gavin4d/dangerDoughnut/PCB/XT30RightAngleAdapter/production/bom.csv

Designator | Footprint | Quantity | Value | LCSC Part #
J1 | AMASS_XT30UPB-F_1x02_P5.0mm_Vertical | 1 | Conn_01x02_Pin
J2 | 0201 | 1 | Conn_01x02_Pin
