gavin4d/dangerDoughnut/PCB/LEDStick/LEDStick.step

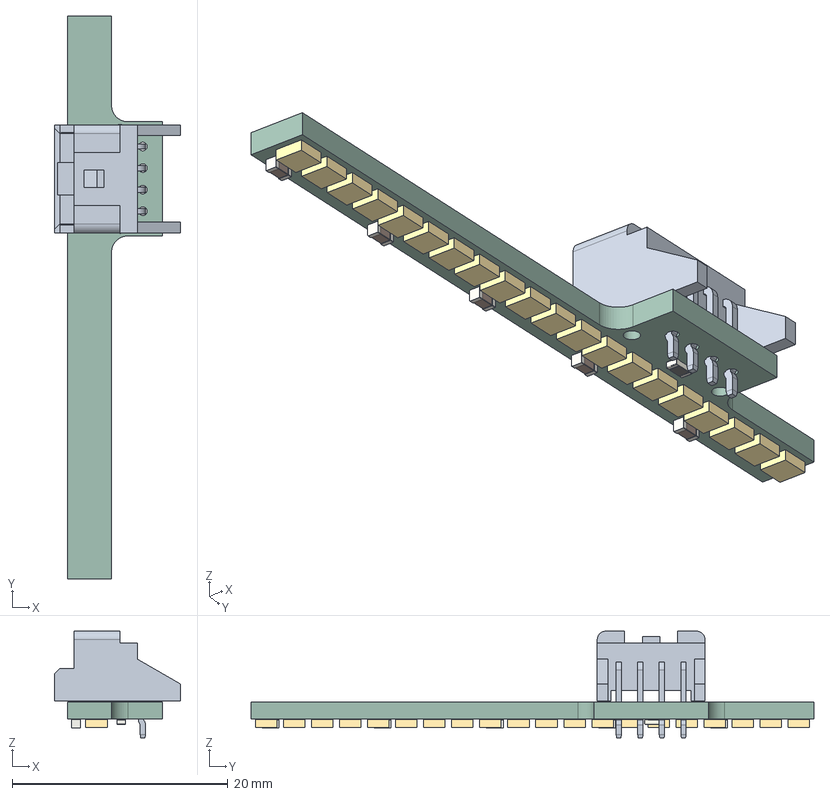
[picture p1: CAD file, 2024-07-29]
PCB/LEDStick/LEDStick.step
11.7 x 52.2 x 9.90 mm
S04B-PASK-2
C_0603_1608Metric x 5
Fuse_0603_1608Metric
_autosave-LEDStick_PCB
