gavin4d/dangerDoughnut/PCB/PowerSwitch/CAD/XT30UPB-F.step

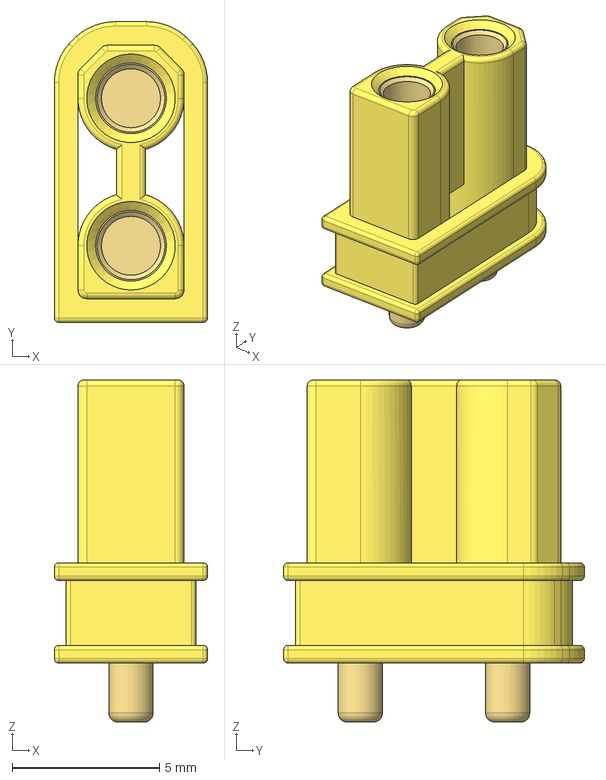
[picture p2: CAD file, 2024-07-29]
PCB/PowerSwitch/CAD/XT30UPB-F.step
5.20 x 10.2 x 11.6 mm
XT30UPB-F x 3
