gavin4d/dangerDoughnut/PCB/PowerSwitch/PowerSwitchV0.2.step

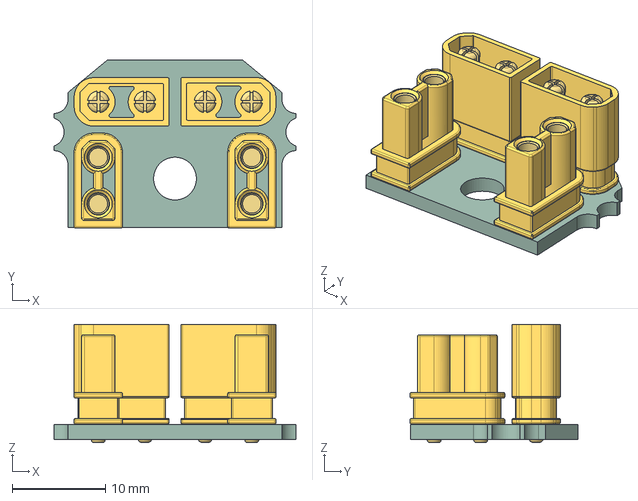
[picture p3: CAD file, 2025-03-31]
PCB/PowerSwitch/PowerSwitchV0.2.step
26.0 x 18.1 x 12.7 mm
Assembly x 4
PowerSwitch_PCB
