gavin4d/dangerDoughnut/PCB/XT30RightAngleAdapter/XT30RightAngleAdapterF.step

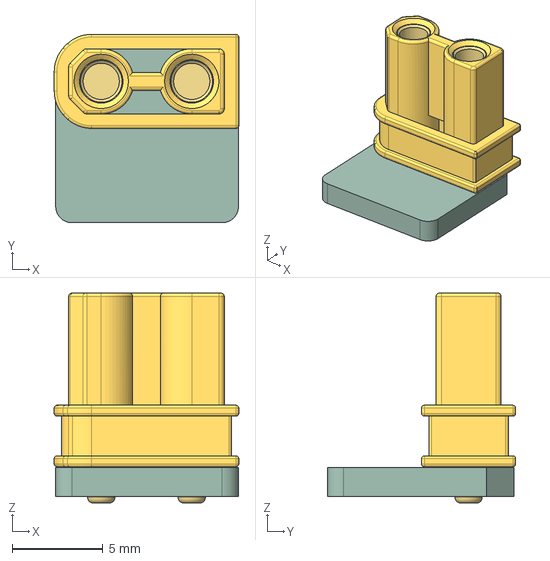
[picture p4: CAD file, 2024-08-08]
PCB/XT30RightAngleAdapter/XT30RightAngleAdapterF.step
10.2 x 10.4 x 11.6 mm
Assembly
_autosave-XT30RightAngleAdapter_PCB
