gavin4d/dangerDoughnut/PCB/DangerDoughnut/CAD/S04B-PASK-2(LF)(SN)--3DModel-STEP-56544.STEP

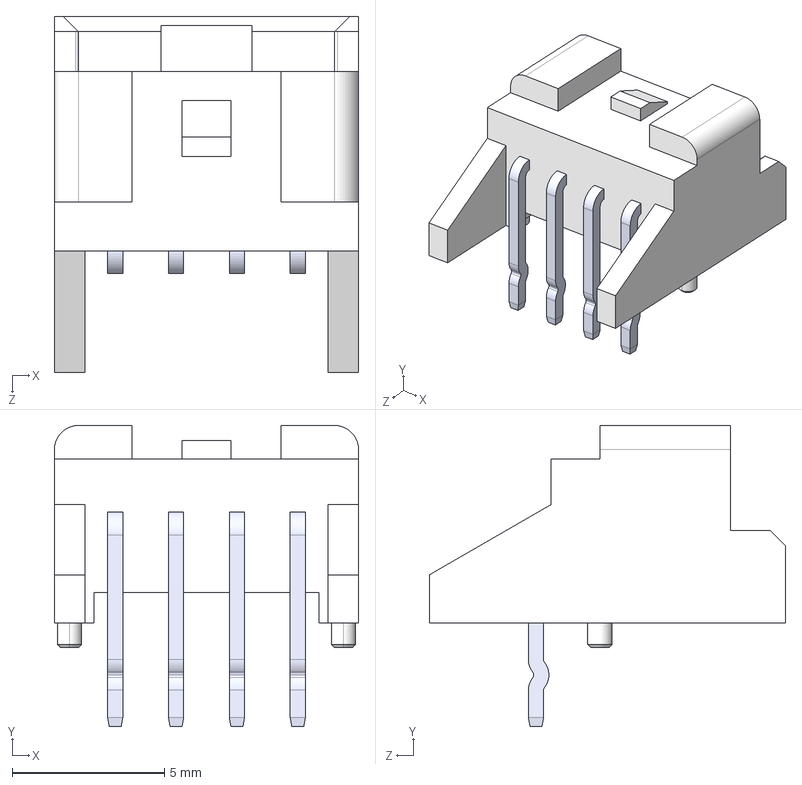
[picture p5: CAD file, 2024-07-29]
PCB/DangerDoughnut/CAD/S04B-PASK-2(LF)(SN)--3DModel-STEP-56544.STEP
10.0 x 9.90 x 11.7 mm
