gavin4d/dangerDoughnut/PCB/PowerSwitch/CAD/XT30UPB-M.step

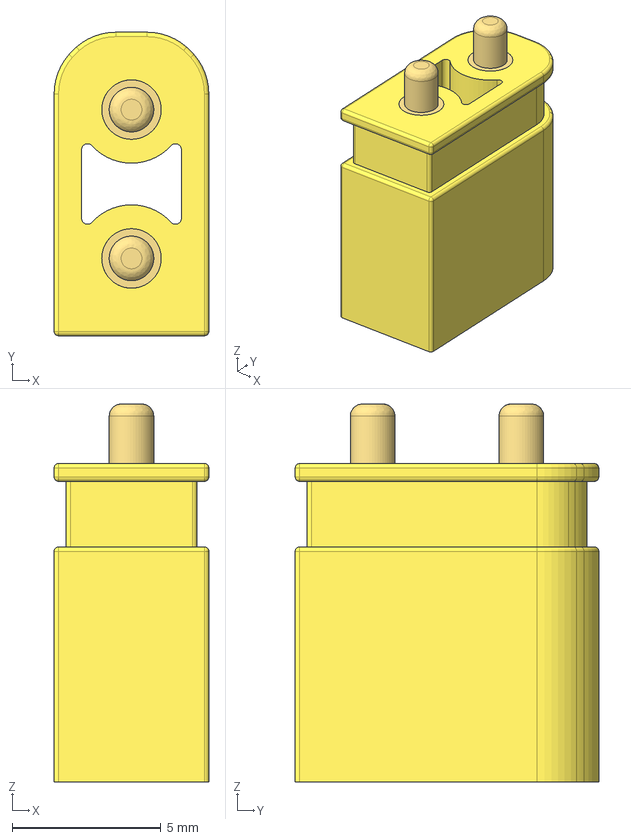
[picture p6: CAD file, 2024-07-29]
PCB/PowerSwitch/CAD/XT30UPB-M.step
5.20 x 10.2 x 12.7 mm
XT30UPB-M x 3
