gavin4d/dangerDoughnut/PCB/XT30RightAngleAdapter/XT30RightAngleAdapter.step

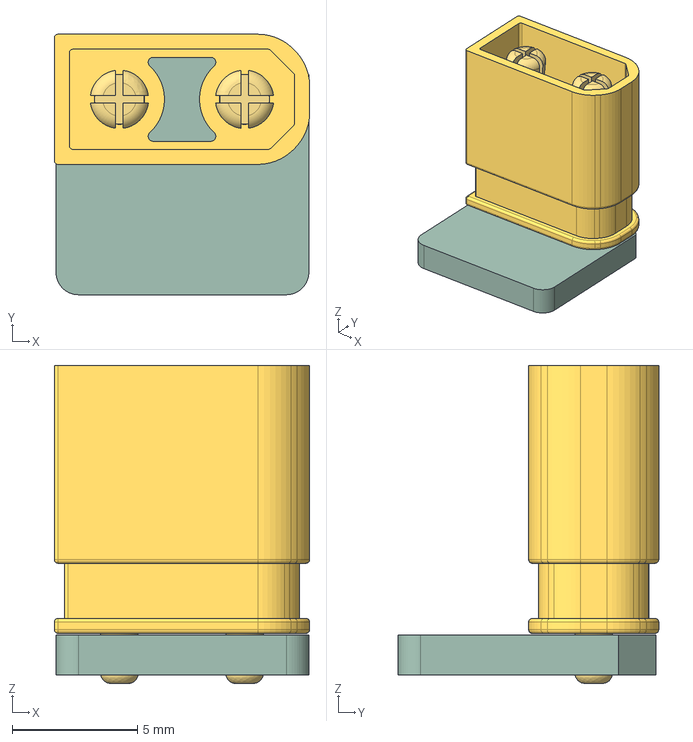
[picture p7: CAD file, 2024-08-08]
PCB/XT30RightAngleAdapter/XT30RightAngleAdapter.step
10.2 x 10.4 x 12.7 mm
Assembly
_autosave-XT30RightAngleAdapter_PCB
