gavin4d/dangerDoughnut/PCB/DangerDoughnut/CAD/QFN32_5X5_EXP.step

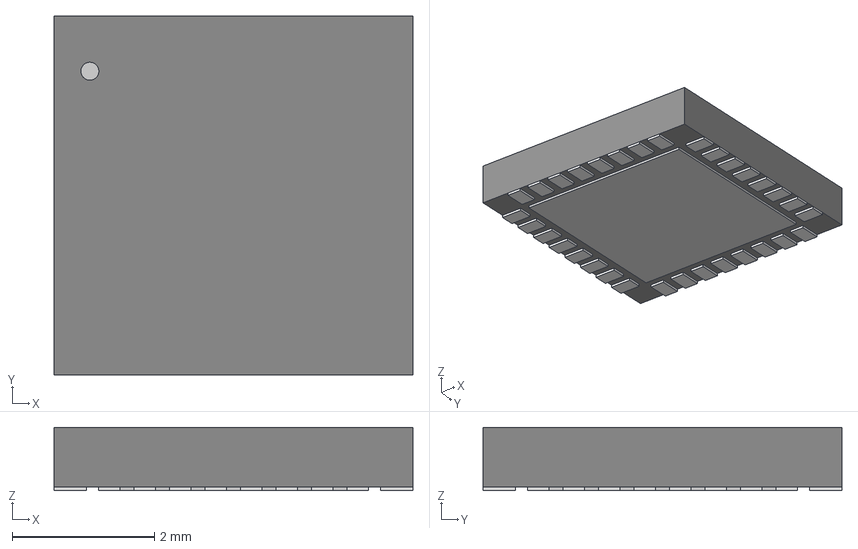
[picture p8: CAD file, 2024-07-29]
PCB/DangerDoughnut/CAD/QFN32_5X5_EXP.step
5.05 x 5.05 x 0.892 mm
