gavin4d/dangerDoughnut/PCB/DangerDoughnut/CAD/QFN24_4X4_SEM.step

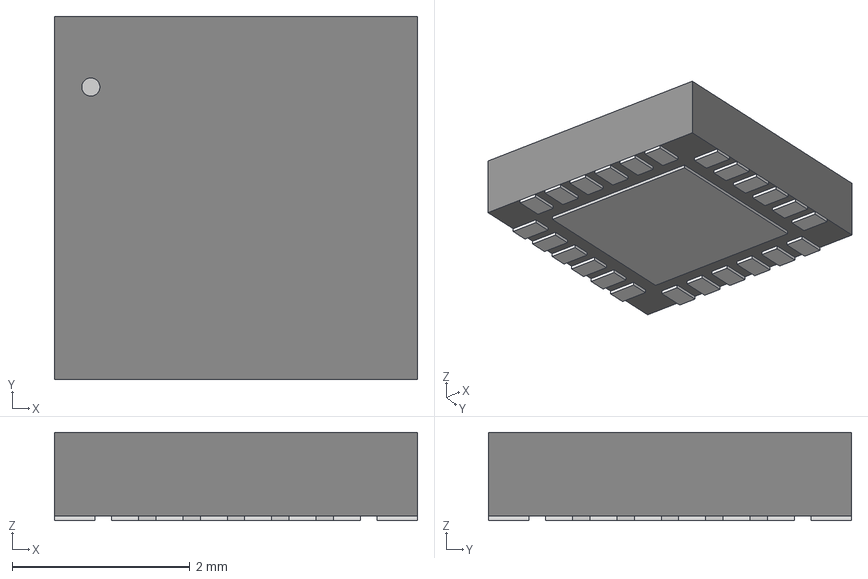
[picture p9: CAD file, 2024-07-29]
PCB/DangerDoughnut/CAD/QFN24_4X4_SEM.step
4.09 x 4.09 x 0.993 mm
