gavin4d/dangerDoughnut/PCB/DangerDoughnut/CAD/HSOP8_STM.step

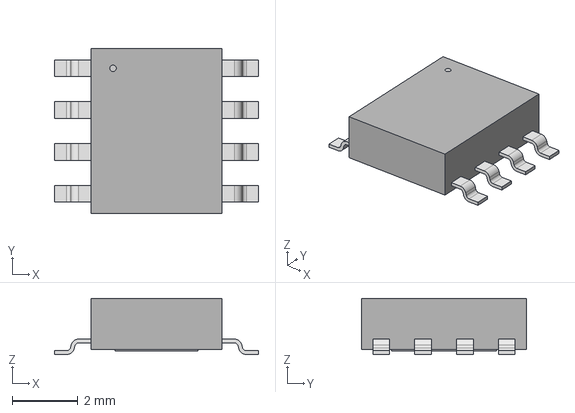
[picture p10: CAD file, 2024-07-29]
PCB/DangerDoughnut/CAD/HSOP8_STM.step
6.20 x 5.00 x 1.70 mm
