gavin4d/dangerDoughnut/PCB/DangerDoughnut/CAD/QFN_31DLTR_STM.step

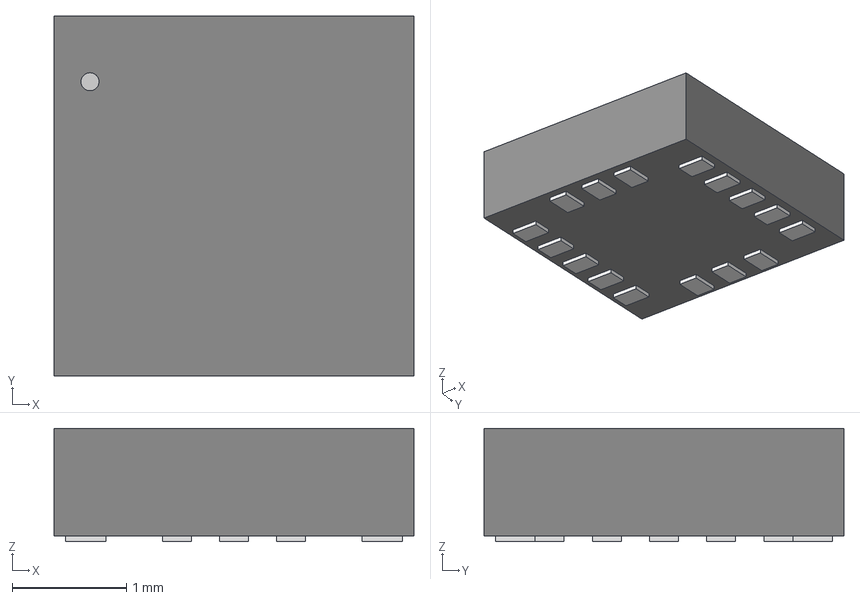
[picture p11: CAD file, 2024-07-29]
PCB/DangerDoughnut/CAD/QFN_31DLTR_STM.step
3.15 x 3.15 x 0.993 mm
