gavin4d/dangerDoughnut/PCB/DangerDoughnut/CAD/MMC5983MA_MEM.step

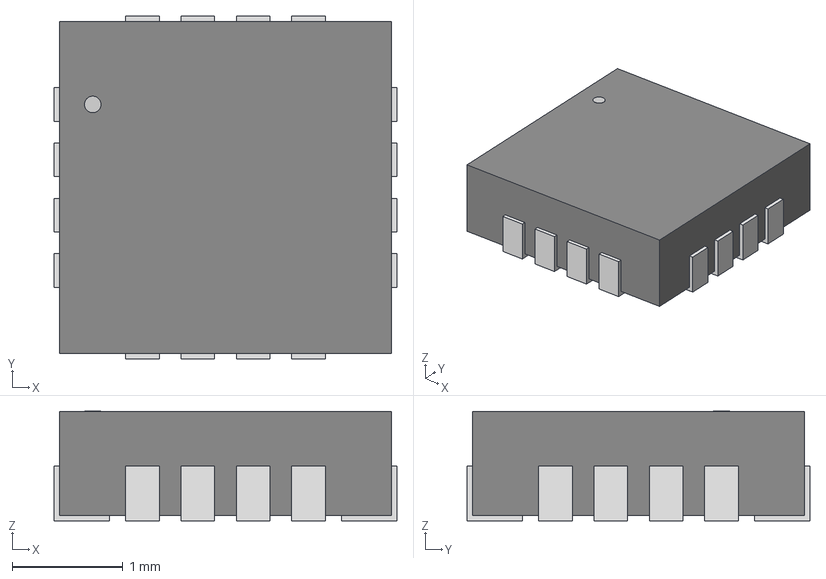
[picture p12: CAD file, 2024-07-29]
PCB/DangerDoughnut/CAD/MMC5983MA_MEM.step
3.10 x 3.10 x 0.993 mm
