gavin4d/dangerDoughnut/PCB/DangerDoughnut/CAD/sru1038.stp

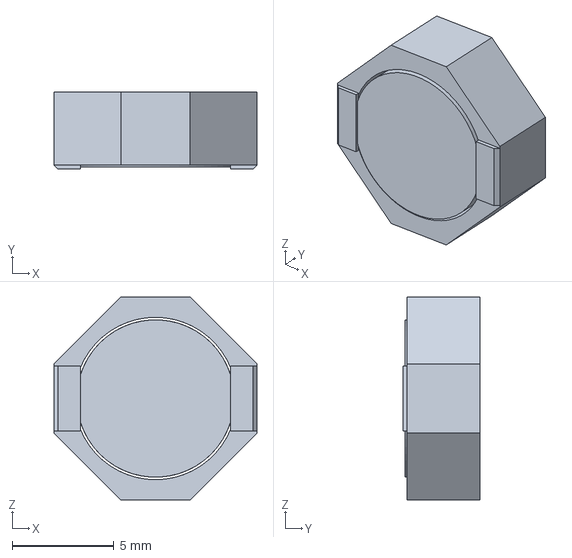
[picture p13: CAD file, 2024-07-29]
PCB/DangerDoughnut/CAD/sru1038.stp
10.0 x 3.80 x 10.0 mm
