gavin4d/dangerDoughnut/PCB/DangerDoughnut/CAD/S02B-PASK-2--3DModel-STEP-272129.STEP

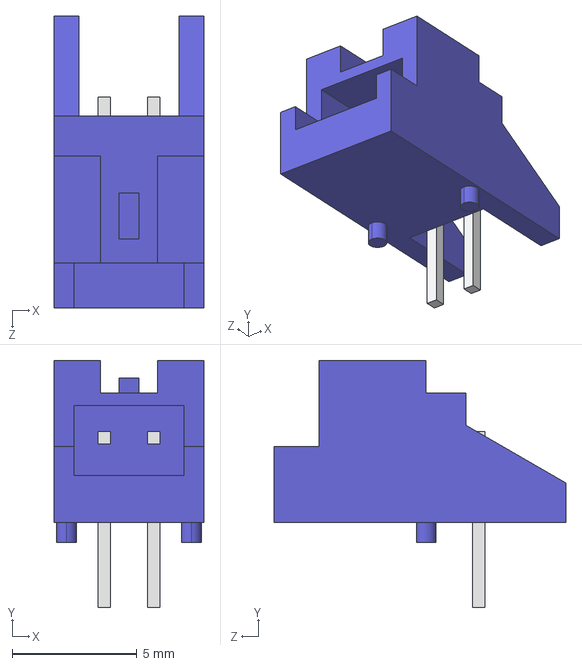
[picture p14: CAD file, 2024-07-29]
PCB/DangerDoughnut/CAD/S02B-PASK-2--3DModel-STEP-272129.STEP
6.00 x 9.90 x 11.7 mm
