gavin4d/dangerDoughnut/PCB/DangerDoughnut/CAD/Amass_XT30PW-M_pcb solder.stp

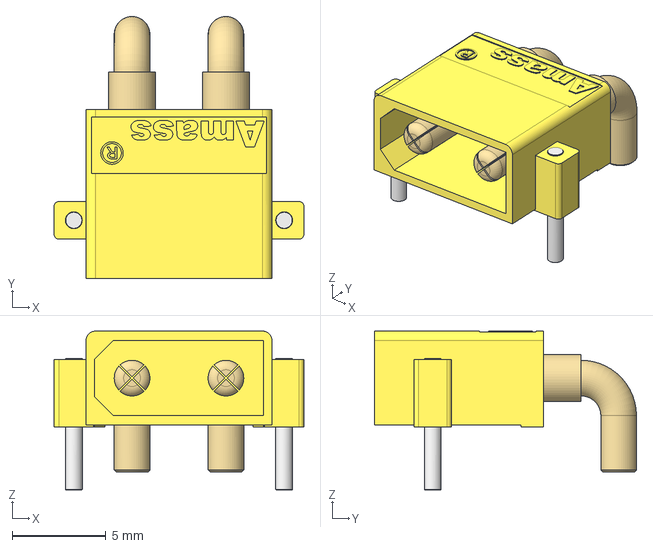
[picture p15: CAD file, 2024-07-29]
PCB/DangerDoughnut/CAD/Amass_XT30PW-M_pcb solder.stp
13.3 x 13.9 x 8.45 mm
