gavin4d/dangerDoughnut/PCB/DangerDoughnut/CAD/SMB_STM.step

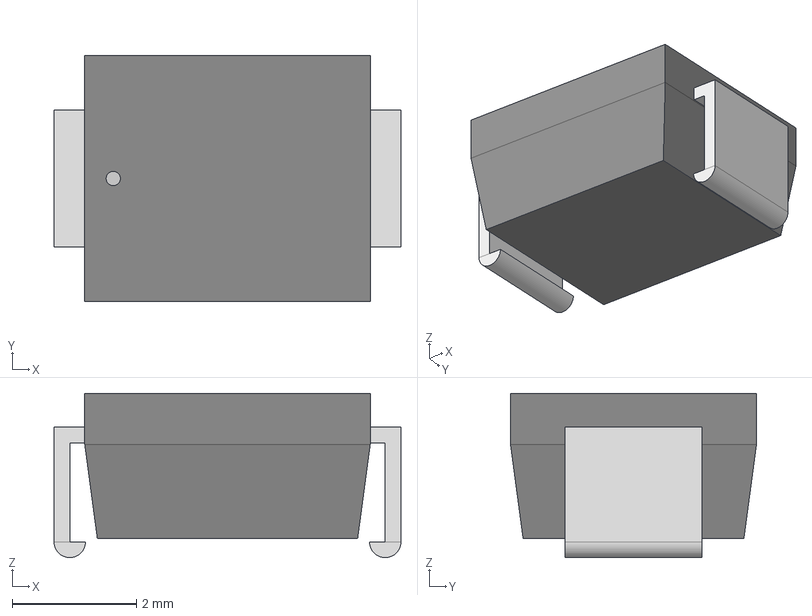
[picture p16: CAD file, 2024-07-29]
PCB/DangerDoughnut/CAD/SMB_STM.step
5.59 x 3.96 x 2.64 mm
