gavin4d/dangerDoughnut/PCB/DangerDoughnut/CAD/DR74.step

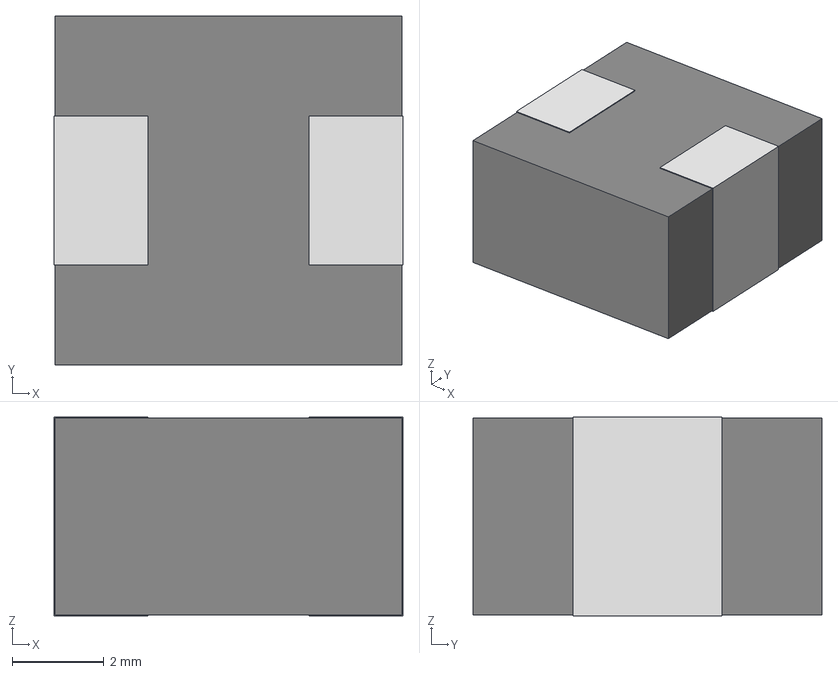
[picture p17: CAD file, 2024-07-29]
PCB/DangerDoughnut/CAD/DR74.step
7.62 x 7.62 x 4.34 mm
