gavin4d/dangerDoughnut/(list of files, cad)

Other CAD files:
PCB/DangerDoughnut/CAD/479480001.stp
PCB/PowerSwitch/PowerSwitch.step
