gavin4d/dangerDoughnut/PCB/XT30RightAngleAdapter/production/ordering_instructions.txt

Ordering Instructions:
Panel dimensions: 73.70 x 75.10 mm.
Solder Mask: Red (Default)
Silkscreen: White (Default)
Layers: 2
Finish: HASL Lead-free (Default)
Thickness: 1.6mm (Default)
Copper weight: 1oz (Default)
Minimum track width: 0.60mm (23.62mil)
Minimum via drill: 0.30mm (11.81mil)
