gavin4d/dangerDoughnut/PCB/DangerDoughnut/DangerDoughnut.kicad_pcb

## KiCad design PCB/DangerDoughnut/DangerDoughnut.kicad_pcb (2025-11-01)

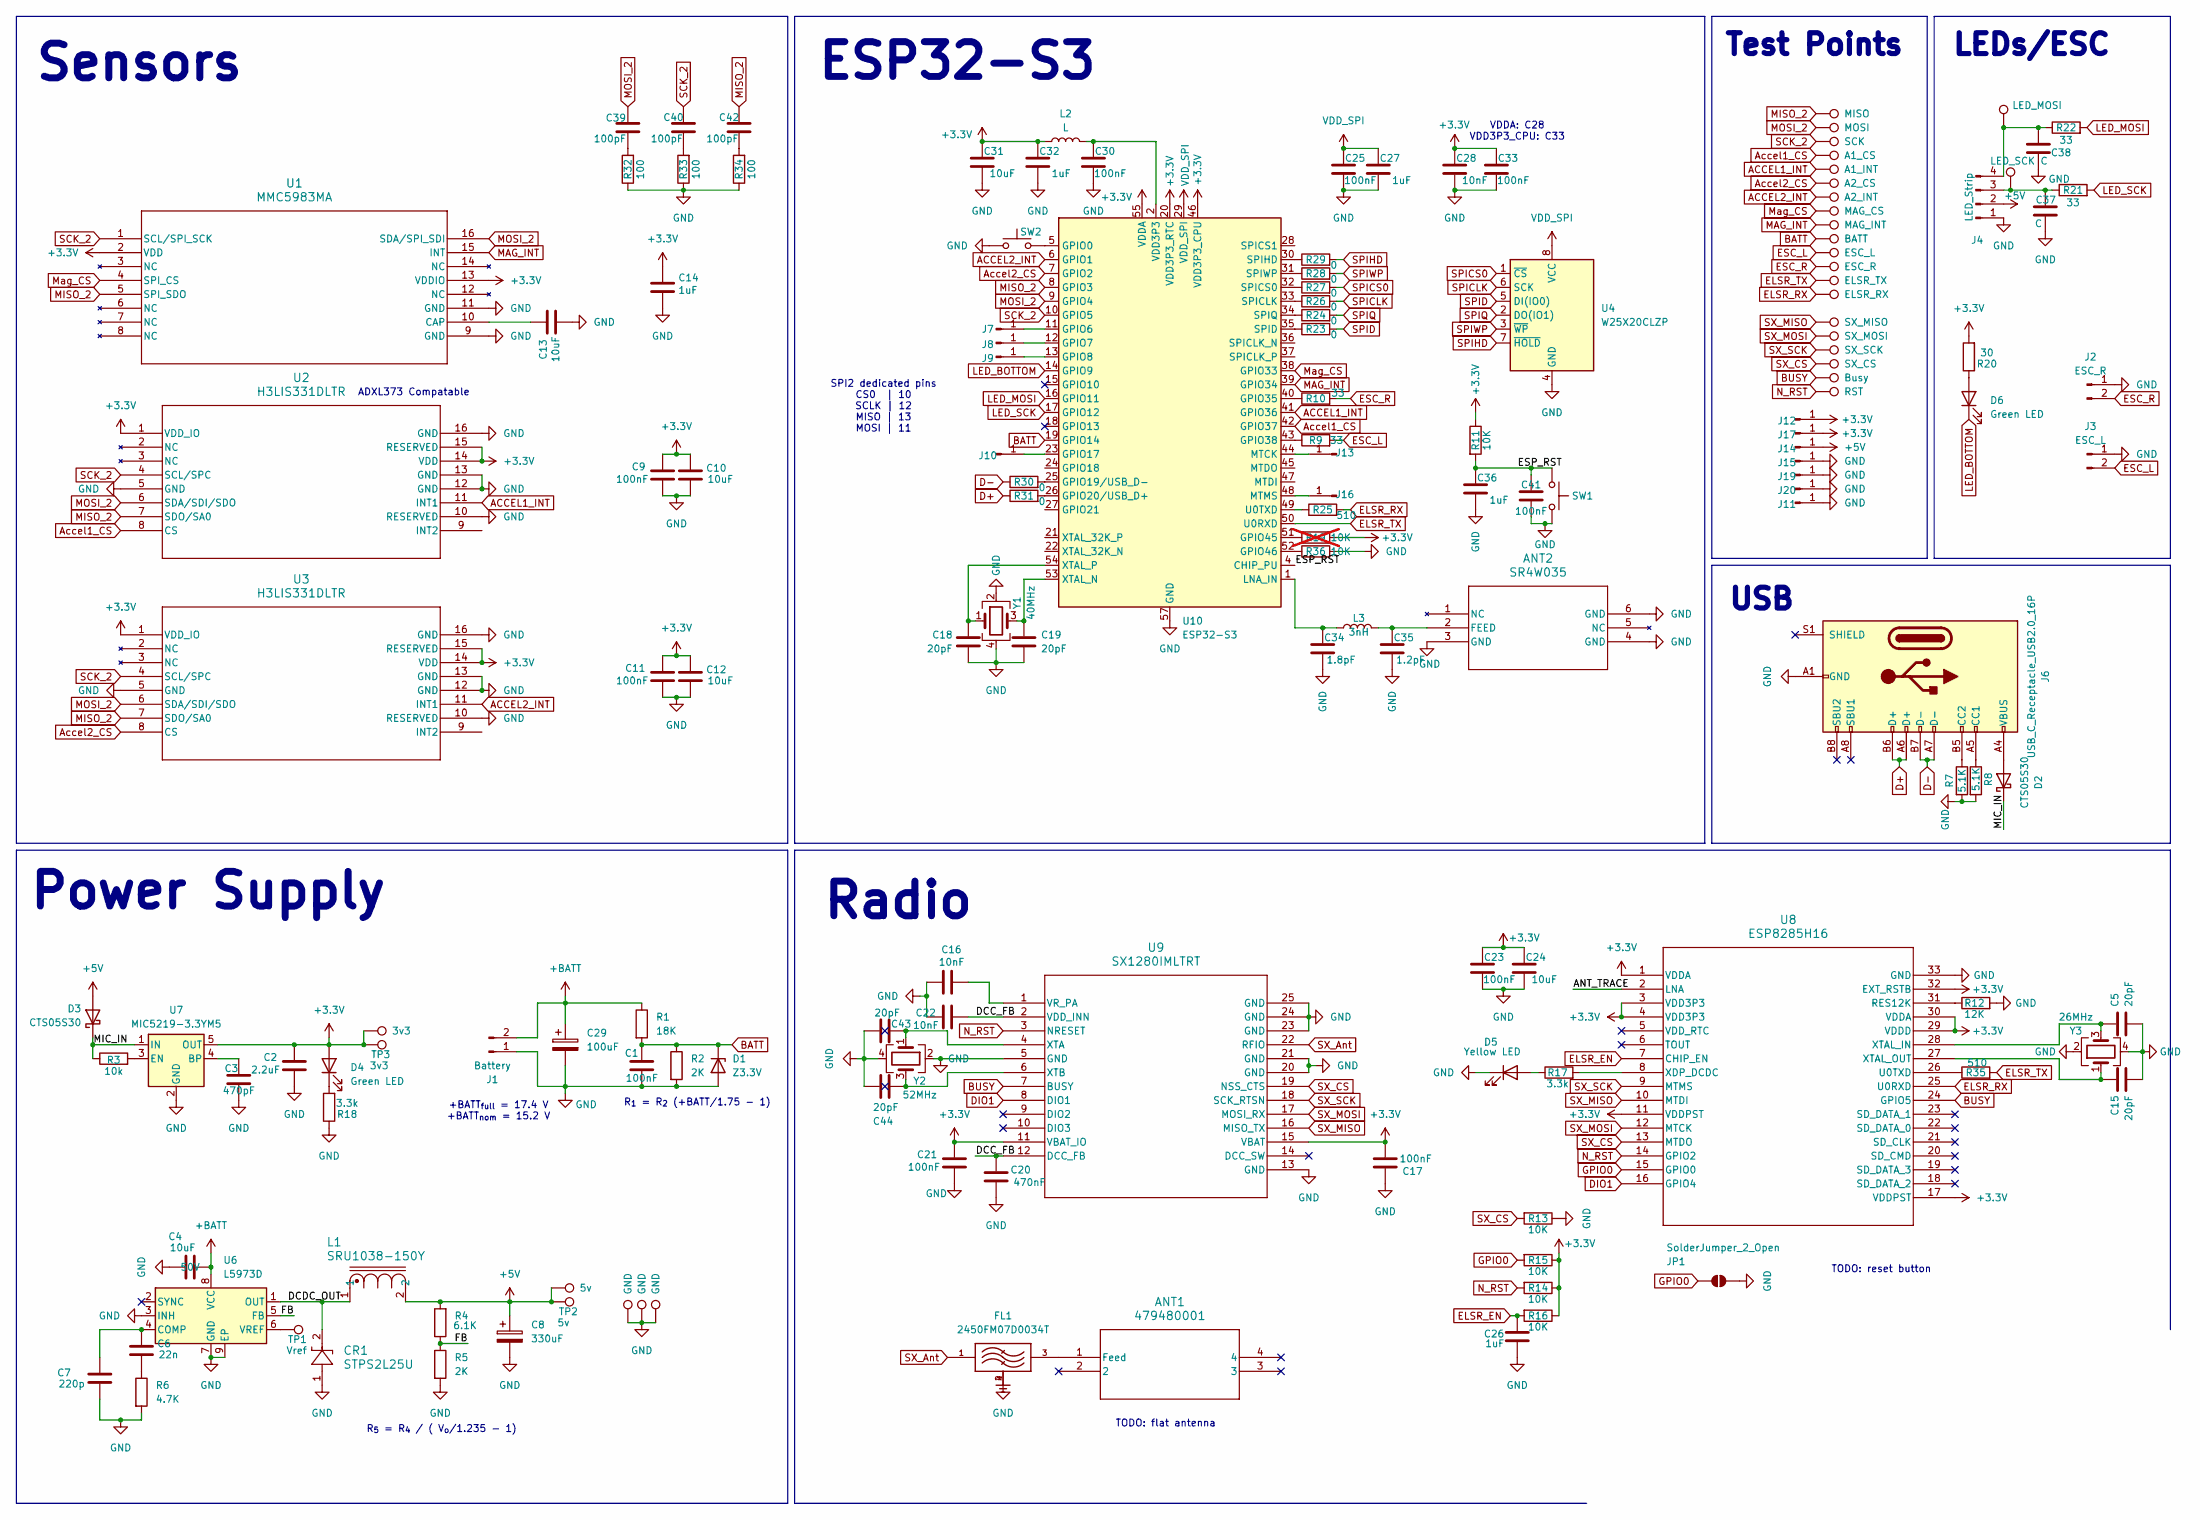
[picture p18: schematic DangerDoughnut.kicad_sch, Danger Doughnut]

Parts:
ANT1: 479480001; ANT_47948-0001_MOL
ANT2: SR4W035; SR4W035_4X6_ANT
C1, C9, C11, C17, C21, C23, C25, C30, C33, C41: 100nF; C_0402_1005Metric
C2: 2.2uF; C_0402_1005Metric
C3: 470pF; C_0402_1005Metric
C4: 10uF; C_1206_3216Metric_Pad1.33x1.80mm_HandSolder; Voltage 50V
C5, C15, C18, C19, C43, C44: 20pF; C_0402_1005Metric_Pad0.74x0.62mm_HandSolder
C6: 22n; C_0402_1005Metric
C7: 220p; C_0402_1005Metric
C8: 330uF; CP_Radial_D6.3mm_P2.50mm
C10, C12, C13, C24, C31: 10uF; C_0805_2012Metric_Pad1.18x1.45mm_HandSolder
C14, C26, C27, C32, C36: 1uF; C_0402_1005Metric
C16, C22, C28: 10nF; C_0402_1005Metric
C20: 470nF; C_0402_1005Metric
C29: 100uF; CP_Right_Angle_D6.3_P2.50_H16.5
C34: 1.8pF; C_0402_1005Metric
C35: 1.2pF; C_0402_1005Metric
C37, C38: C; C_0402_1005Metric
C39, C40, C42: 100pF; C_0402_1005Metric
CR1: STPS2L25U; SMB_STM
D1: Z3.3V; D_SOD-123
D2, D3: CTS05S30; D_0805_2012Metric
D4, D6: Green LED; LED_0805_2012Metric
D5: Yellow LED; LED_0805_2012Metric
FL1: 2450FM07D0034T; FIL_2450FM07D0034T; PARTREV 1.2
J1: Battery; AMASS_XT30PW-M_1x02_P2.50mm_Horizontal
J2: ESC_R; JST_S02B-PASK-2_LF__SN__1
J3: ESC_L; JST_S02B-PASK-2_LF__SN__1
J4: LED_Strip; JST_S04B-PASK-2_LF__SN_
J6: USB_C_Receptacle_USB2.0_16P; USB_C_Receptacle_GCT_USB4105-xx-A_16P_TopMnt_Horizontal
J7, J8, J9, J10, J11, J12, J13, J14, J15, J16, J17, J19, J20: Conn_01x01_Pin; SolderWirePad_1x01_SMD_1x2mm
JP1: SolderJumper_2_Open; SolderJumper-2_P1.3mm_Open_RoundedPad1.0x1.5mm
L1: SRU1038-150Y; DR74
L2: L; L_0402_1005Metric_Pad0.77x0.64mm_HandSolder
L3: 3nH; L_0402_1005Metric_Pad0.77x0.64mm_HandSolder
R1: 18K; R_0402_1005Metric
R2, R5: 2K; R_0402_1005Metric
R3: 10k; R_0402_1005Metric
R4: 6.1K; R_0402_1005Metric
R6: 4.7K; R_0402_1005Metric
R7, R8: 5.1K; R_0402_1005Metric
R9, R10, R21, R22: 33; R_0402_1005Metric
R11, R13, R14, R15, R16, R36: 10K; R_0402_1005Metric
R12: 12K; R_0402_1005Metric
R17, R18: 3.3k; R_0402_1005Metric
R19: 10K; R_0402_1005Metric; not fitted
R20: 30; R_0402_1005Metric
R23, R24, R26, R27, R28, R29, R30, R31: 0; R_0402_1005Metric
R25, R35: 510; R_0402_1005Metric
R32, R33, R34: 100; R_0402_1005Metric
SW1, SW2: SW_Push; Pad_Button
TP1: Vref; TestPoint_Pad_D1.0mm
TP2: 5v; TestPoint_Pad_D1.0mm
TP3: 3v3; TestPoint_Pad_D1.0mm
TP4: SX_MISO; Test_Via_small
TP5: MISO; Test_Via
TP6: MOSI; Test_Via
TP7: SCK; Test_Via
TP8: ELSR_TX; Test_Via
TP9: ELSR_RX; Test_Via
TP10: A1_CS; Test_Via
TP11: A1_INT; Test_Via
TP12: A2_CS; Test_Via
TP13: A2_INT; Test_Via
TP14: MAG_CS; Test_Via
TP15: MAG_INT; Test_Via
TP16: BATT; Test_Via
TP17: SX_MOSI; Test_Via_small
TP18: LED_MOSI; Test_Via
TP19: LED_SCK; Test_Via
TP20: ESC_L; Test_Via
TP21: ESC_R; Test_Via
TP22: SX_SCK; Test_Via_small
TP23: SX_CS; Test_Via_small
TP24: Busy; Test_Via_small
TP25: RST; Test_Via_small
TP26: 5v; Test_Via
TP27: 3v3; Test_Via
TP28, TP29, TP30: GND; Test_Via
U1: MMC5983MA; MMC5983MA_MEM
U2, U3: H3LIS331DLTR; QFN_31DLTR_STM
U4: W25X20CLZP; SOIC-8_5.23x5.23mm_P1.27mm
U6: L5973D; HSOP-8-1EP_3.9x4.9mm_P1.27mm_EP2.41x3.1mm_ThermalVias
U7: MIC5219-3.3YM5; SOT-23-5
U8: ESP8285H16; QFN32_5X5_EXP
U9: SX1280IMLTRT; QFN24_4X4_SEM
U10: ESP32-S3; QFN-56-1EP_7x7mm_P0.4mm_EP4x4mm
Y1: 40MHz; Crystal_SMD_2016-4Pin_2.0x1.6mm
Y2: 52MHz; Crystal_SMD_2016-4Pin_2.0x1.6mm
Y3: 26MHz; Crystal_SMD_2016-4Pin_2.0x1.6mm

Connections:
+3.3V: C2.1, C9.1, C10.2, C11.1, C12.2, C14.2, C17.2, C21.1, C23.1, C24.1, C28.1, C31.1, C32.1, C33.1, D4.2 (A), J12.1, J17.1, L2.1, R11.1, R14.1, R15.1, R16.1, R19.2, R20.2, TP3.1, TP27.1, U1.2 (VDD), U1.13 (VDDIO), U2.1 (VDD_IO), U2.14 (VDD), U2.15 (RESERVED), U3.1 (VDD_IO), U3.14 (VDD), U3.15 (RESERVED), U7.5 (OUT), U8.1 (VDDA), U8.3 (VDD3P3), U8.4 (VDD3P3), U8.11 (VDDPST), U8.17 (VDDPST), U8.29 (VDDD), U8.30 (VDDA), U8.32 (EXT_RSTB), U9.11 (VBAT_IO), U9.15 (VBAT), U10.20 (VDD3P3_RTC), U10.46 (VDD3P3_CPU), U10.55 (VDDA), U10.56 (VDDA)
+5V: C8.1, D3.2 (A), J4.2, J14.1, L1.2, R4.2, TP2.1, TP26.1
+BATT: C4.2, C29.1, J1.2, R1.1, U6.8 (VCC)
/ANT_TRACE: U8.2 (LNA)
/DCC_FB: C20.1, C22.1, U9.2 (VDD_INN), U9.12 (DCC_FB)
/DCDC_OUT: CR1.2, L1.1, U6.1 (OUT)
/ESP_RST: C36.1, C41.1, R11.2, SW1.1, U10.4 (CHIP_PU)
/FB: R4.1, R5.1, U6.5 (FB)
/MIC_IN: D2.1 (K), D3.1 (K), R3.1, U7.1 (IN)
ACCEL1_INT: TP11.1, U2.11 (INT1), U10.41 (GPIO36)
ACCEL2_INT: TP13.1, U3.11 (INT1), U10.6 (GPIO1)
Accel1_CS: TP10.1, U2.8 (CS), U10.42 (GPIO37)
Accel2_CS: TP12.1, U3.8 (CS), U10.7 (GPIO2)
BATT: C1.1, D1.1 (K), R1.2, R2.1, TP16.1, U10.19 (GPIO14)
BUSY: TP24.1, U8.24 (GPIO5), U9.7 (BUSY)
D+: J6.A6 (D+), J6.B6 (D+), R31.1
D-: J6.A7 (D-), J6.B7 (D-), R30.1
DIO1: U8.16 (GPIO4), U9.8 (DIO1)
ELSR_EN: C26.1, R16.2, U8.7 (CHIP_EN)
ELSR_RX: R25.2, TP9.1, U8.25 (U0RXD)
ELSR_TX: R35.2, TP8.1, U10.50 (U0RXD)
ESC_L: J3.2, R9.2, TP20.1
ESC_R: J2.2, R10.2, TP21.1
GND: ANT2.3 (GND), ANT2.4 (GND), ANT2.6 (GND), C1.2, C2.2, C3.2, C4.1, C5.2, C7.1, C8.2, C9.2, C10.1, C11.2, C12.1, C13.2, C14.1, C15.2, C16.2, C17.1, C18.2, C19.2, C20.2, C21.2, C22.2, C23.2, C24.2, C25.2, C26.2, C27.2, C28.2, C29.2, C30.2, C31.2, C32.2, C33.2, C34.2, C35.2, C36.2, C37.2, C38.2, C41.2, C43.1, C44.1, CR1.1, D1.2 (A), D5.1 (K), FL1.2, FL1.4, J1.1, J2.1, J3.1, J4.1, J6.A1 (GND), J6.A12 (GND), J6.B1 (GND), J6.B12 (GND), J11.1, J15.1, J19.1, J20.1, JP1.1 (A), R2.2, R5.2, R6.2, R7.2, R8.2, R12.2, R13.1, R18.1, R32.1, R33.1, R34.1, R36.2, SW1.2, SW2.1, TP28.1, TP29.1, TP30.1, U1.9 (GND), U1.11 (GND), U2.5 (GND), U2.10 (RESERVED), U2.12 (GND), U2.13 (GND), U2.16 (GND), U3.5 (GND), U3.10 (RESERVED), U3.12 (GND), U3.13 (GND), U3.16 (GND), U4.4 (GND), U6.3 (INH), U6.7 (GND), U6.9 (EP), U7.2 (GND), U8.33 (GND), U9.5 (GND), U9.13 (GND), U9.20 (GND), U9.21 (GND), U9.23 (GND), U9.24 (GND), U9.25 (GND), U10.57 (GND), Y1.2, Y1.4, Y2.2, Y2.4, Y3.2, Y3.4
GPIO0: JP1.2 (B), R15.2, U8.15 (GPIO0)
LED_BOTTOM: D6.1 (K), U10.14 (GPIO9)
LED_MOSI: R22.2, U10.16 (GPIO11)
LED_SCK: R21.2, U10.17 (GPIO12)
MAG_INT: TP15.1, U1.15 (INT), U10.39 (GPIO34)
MISO_2: C42.1, TP5.1, U1.5 (SPI_SDO), U2.7 (SDO/SA0), U3.7 (SDO/SA0), U10.8 (GPIO3)
MOSI_2: C39.1, TP6.1, U1.16 (SDA/SPI_SDI), U2.6 (SDA/SDI/SDO), U3.6 (SDA/SDI/SDO), U10.9 (GPIO4)
Mag_CS: TP14.1, U1.4 (SPI_CS), U10.38 (GPIO33)
N_RST: R14.2, TP25.1, U8.14 (GPIO2), U9.3 (NRESET)
unnamed: ANT1.1 (Feed), FL1.3
unnamed: ANT2.2 (FEED), C35.1, L3.2
unnamed: C6.1, R6.1
unnamed: C30.1, L2.2, U10.2 (VDD3P3), U10.3 (VDD3P3)
unnamed: C39.2, R32.2
unnamed: C40.2, R33.2
unnamed: C42.2, R34.2
unnamed: D2.2 (A), J6.A4 (VBUS), J6.A9 (VBUS), J6.B4 (VBUS), J6.B9 (VBUS)
unnamed: D4.1 (K), R18.2
unnamed: D5.2 (A), R17.1
unnamed: D6.2 (A), R20.1
unnamed: C37.1, J4.3, R21.1, TP19.1
unnamed: C38.1, J4.4, R22.1, TP18.1
unnamed: J6.A5 (CC1), R8.1
unnamed: J6.B5 (CC2), R7.1
unnamed: J7.1, U10.11 (GPIO6)
unnamed: J8.1, U10.12 (GPIO7)
unnamed: J9.1, U10.13 (GPIO8)
unnamed: J10.1, U10.23 (GPIO17)
unnamed: J13.1, U10.44 (MTCK)
unnamed: J16.1, U10.48 (MTMS)
unnamed: C13.1, U1.10 (CAP)
unnamed: C6.2, C7.2, U6.4 (COMP)
unnamed: TP1.1, U6.6 (VREF)
unnamed: C3.1, U7.4 (BP)
unnamed: R3.2, U7.3 (EN)
unnamed: R12.1, U8.31 (RES12K)
unnamed: R35.1, U8.26 (U0TXD)
unnamed: R17.2, U8.8 (XDP_DCDC)
unnamed: C5.1, U8.28 (XTAL_IN), Y3.3
unnamed: C15.1, U8.27 (XTAL_OUT), Y3.1
unnamed: C16.1, U9.1 (VR_PA)
unnamed: C43.2, U9.4 (XTA), Y2.1
unnamed: C44.2, U9.6 (XTB), Y2.3
unnamed: SW2.2, U10.5 (GPIO0)
unnamed: R30.2, U10.25 (GPIO19/USB_D-)
unnamed: R31.2, U10.26 (GPIO20/USB_D+)
unnamed: R10.1, U10.40 (GPIO35)
unnamed: R9.1, U10.43 (GPIO38)
unnamed: R19.1, U10.51 (GPIO45)
unnamed: R36.1, U10.52 (GPIO46)
unnamed: C34.1, L3.1, U10.1 (LNA_IN)
unnamed: R26.1, U10.33 (SPICLK)
unnamed: R27.1, U10.32 (SPICS0)
unnamed: R23.1, U10.35 (SPID)
unnamed: R29.1, U10.30 (SPIHD)
unnamed: R24.1, U10.34 (SPIQ)
unnamed: R28.1, U10.31 (SPIWP)
unnamed: R25.1, U10.49 (U0TXD)
unnamed: C19.1, U10.53 (XTAL_N), Y1.3
unnamed: C18.1, U10.54 (XTAL_P), Y1.1
SCK_2: C40.1, TP7.1, U1.1 (SCL/SPI_SCK), U2.4 (SCL/SPC), U3.4 (SCL/SPC), U10.10 (GPIO5)
SPICLK: R26.2, U4.6 (SCK)
SPICS0: R27.2, U4.1 (~CS)
SPID: R23.2, U4.5 (DI(IO0))
SPIHD: R29.2, U4.7 (~HOLD)
SPIQ: R24.2, U4.2 (DO(IO1))
SPIWP: R28.2, U4.3 (~WP)
SX_Ant: FL1.1, U9.22 (RFIO)
SX_CS: R13.2, TP23.1, U8.13 (MTDO), U9.19 (NSS_CTS)
SX_MISO: TP4.1, U8.10 (MTDI), U9.16 (MISO_TX)
SX_MOSI: TP17.1, U8.12 (MTCK), U9.17 (MOSI_RX)
SX_SCK: TP22.1, U8.9 (MTMS), U9.18 (SCK_RTSN)
VDD_SPI: C25.1, C27.1, U4.8 (VCC), U10.29 (VDD_SPI)

Notes on the sheet:
Sensors
TODO: reset button
USB
ESP32-S3
Radio
Test Points
ADXL373 Compatable
+BATT_{full} = 17.4 V +BATT_{nom} = 15.2 V
LEDs/ESC
Power Supply
TODO: flat antenna
SPI2 dedicated pins CS0 | 10 SCLK | 12 MISO | 13 MOSI | 11
R_{5} = R_{4} / ( V_{o}/1.235 - 1)
VDDA: C28 VDD3P3_CPU: C33
R_{1} = R_{2} (+BATT/1.75 - 1)

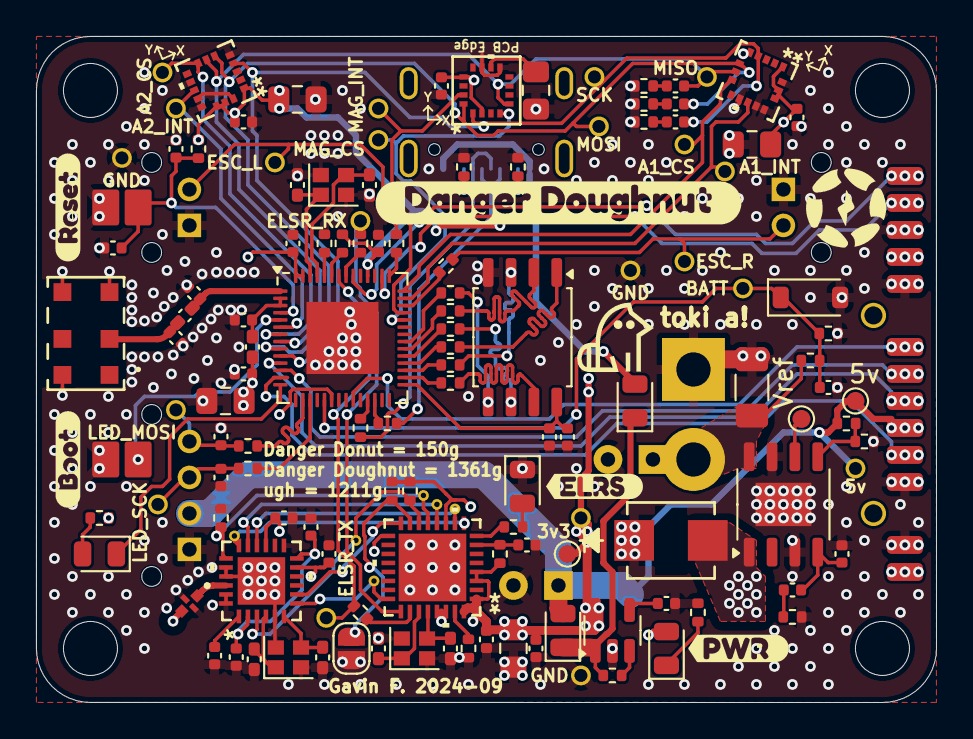
[picture p19: board DangerDoughnut.kicad_pcb from above]

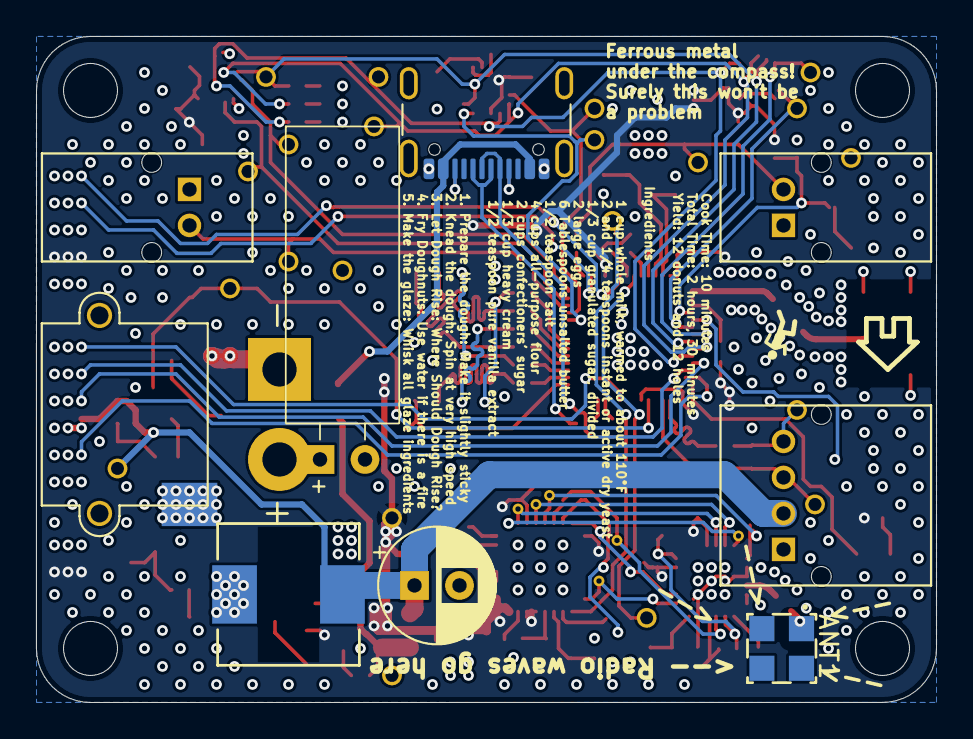
[picture p20: board DangerDoughnut.kicad_pcb from below]

Board: 4 copper layers, 50.0 x 37.0 mm, 161 parts (9 on the bottom side), 96 nets.

Other parts of the board:
kibuzzard-66EFAD11: G***; kibuzzard-66EFAD11
kibuzzard-66EFAD22: G***; kibuzzard-66EFAD22
kibuzzard-66F236AA: G***; kibuzzard-66F236AA
kibuzzard-672AA985: G***; kibuzzard-672AA985
kibuzzard-66936F84: G***; kibuzzard-66936F84
