gavin4d/dangerDoughnut/PCB/LEDStick/LEDStick.kicad_pcb

## KiCad design PCB/LEDStick/LEDStick.kicad_pcb (2024-10-24)

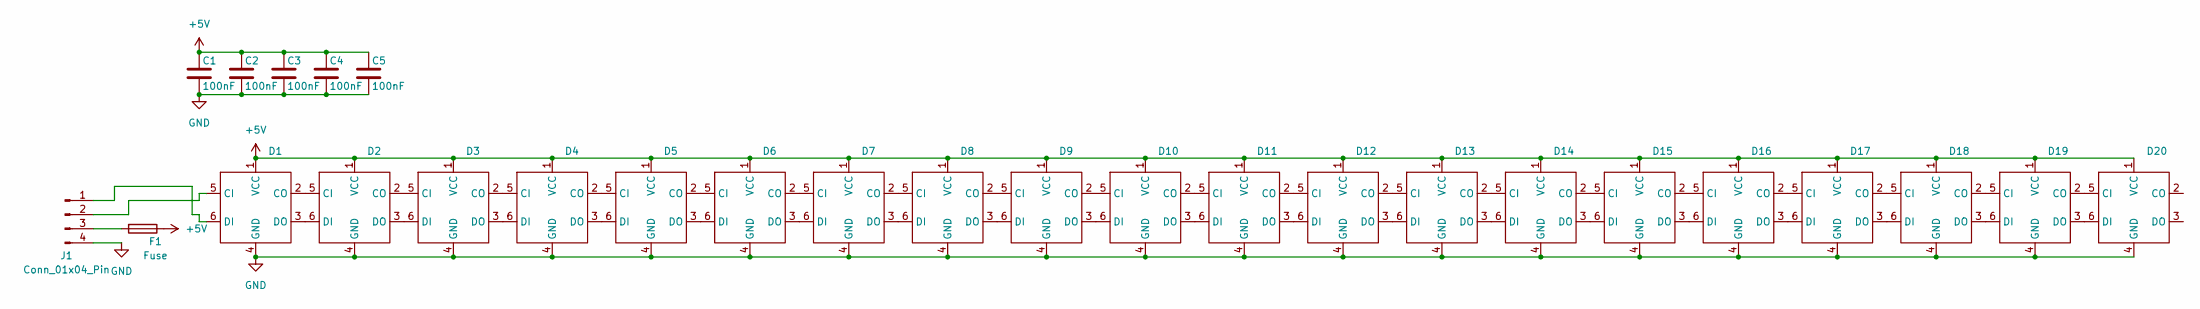
[picture p21: schematic LEDStick.kicad_sch]

Parts:
C1, C2, C3, C4, C5: 100nF; C_0603_1608Metric
D1, D2, D3, D4, D5, D6, D7, D8, D9, D10, D11, D12, D13, D14, D15, D16, D17, D18, D19, D20: HD107s
F1: Fuse; Fuse_0603_1608Metric
J1: Conn_01x04_Pin; JST_S04B-PASK-2_LF__SN_

Connections:
+5V: C1.1, C2.1, C3.1, C4.1, C5.1, D1.1 (VCC), D2.1 (VCC), D3.1 (VCC), D4.1 (VCC), D5.1 (VCC), D6.1 (VCC), D7.1 (VCC), D8.1 (VCC), D9.1 (VCC), D10.1 (VCC), D11.1 (VCC), D12.1 (VCC), D13.1 (VCC), D14.1 (VCC), D15.1 (VCC), D16.1 (VCC), D17.1 (VCC), D18.1 (VCC), D19.1 (VCC), D20.1 (VCC), F1.1
GND: C1.2, C2.2, C3.2, C4.2, C5.2, D1.4 (GND), D2.4 (GND), D3.4 (GND), D4.4 (GND), D5.4 (GND), D6.4 (GND), D7.4 (GND), D8.4 (GND), D9.4 (GND), D10.4 (GND), D11.4 (GND), D12.4 (GND), D13.4 (GND), D14.4 (GND), D15.4 (GND), D16.4 (GND), D17.4 (GND), D18.4 (GND), D19.4 (GND), D20.4 (GND), J1.4
unnamed: D1.5 (CI), J1.2
unnamed: D1.2 (CO), D2.5 (CI)
unnamed: D1.6 (DI), J1.1
unnamed: D1.3 (DO), D2.6 (DI)
unnamed: D2.2 (CO), D3.5 (CI)
unnamed: D2.3 (DO), D3.6 (DI)
unnamed: D3.2 (CO), D4.5 (CI)
unnamed: D3.3 (DO), D4.6 (DI)
unnamed: D4.2 (CO), D5.5 (CI)
unnamed: D4.3 (DO), D5.6 (DI)
unnamed: D5.2 (CO), D6.5 (CI)
unnamed: D5.3 (DO), D6.6 (DI)
unnamed: D6.2 (CO), D7.5 (CI)
unnamed: D6.3 (DO), D7.6 (DI)
unnamed: D7.2 (CO), D8.5 (CI)
unnamed: D7.3 (DO), D8.6 (DI)
unnamed: D8.2 (CO), D9.5 (CI)
unnamed: D8.3 (DO), D9.6 (DI)
unnamed: D9.2 (CO), D10.5 (CI)
unnamed: D10.2 (CO), D11.5 (CI)
unnamed: D9.3 (DO), D10.6 (DI)
unnamed: D10.3 (DO), D11.6 (DI)
unnamed: D11.2 (CO), D12.5 (CI)
unnamed: D11.3 (DO), D12.6 (DI)
unnamed: D12.2 (CO), D13.5 (CI)
unnamed: D12.3 (DO), D13.6 (DI)
unnamed: D13.2 (CO), D14.5 (CI)
unnamed: D13.3 (DO), D14.6 (DI)
unnamed: D14.2 (CO), D15.5 (CI)
unnamed: D14.3 (DO), D15.6 (DI)
unnamed: D15.2 (CO), D16.5 (CI)
unnamed: D15.3 (DO), D16.6 (DI)
unnamed: D16.2 (CO), D17.5 (CI)
unnamed: D16.3 (DO), D17.6 (DI)
unnamed: D17.2 (CO), D18.5 (CI)
unnamed: D17.3 (DO), D18.6 (DI)
unnamed: D18.2 (CO), D19.5 (CI)
unnamed: D18.3 (DO), D19.6 (DI)
unnamed: D19.2 (CO), D20.5 (CI)
unnamed: D19.3 (DO), D20.6 (DI)
unnamed: F1.2, J1.3

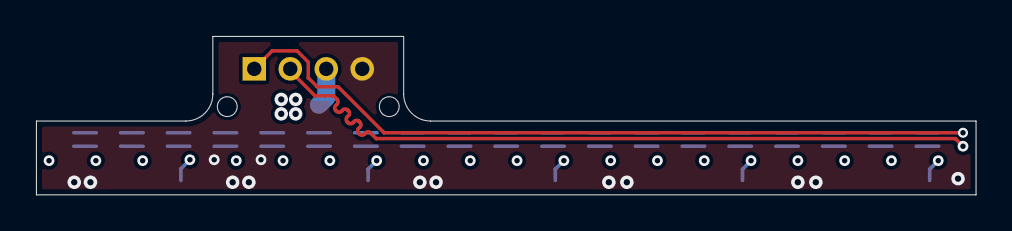
[picture p22: board LEDStick.kicad_pcb from above]

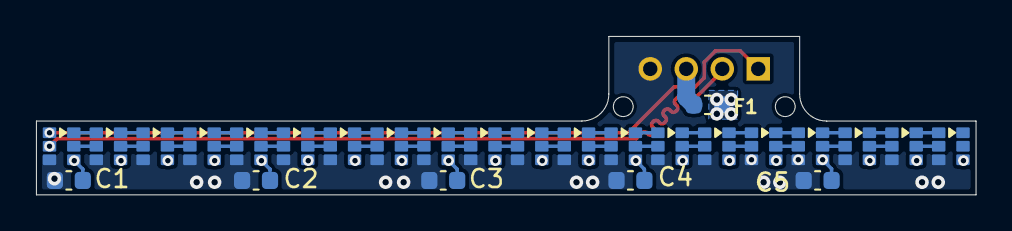
[picture p23: board LEDStick.kicad_pcb from below]

Board: 4 copper layers, 52.2 x 8.8 mm, 27 parts (26 on the bottom side), 43 nets.
