gavin4d/dangerDoughnut/PCB/PowerSwitch/PowerSwitch.kicad_pcb

## KiCad design PCB/PowerSwitch/PowerSwitch.kicad_pcb (2024-08-08)

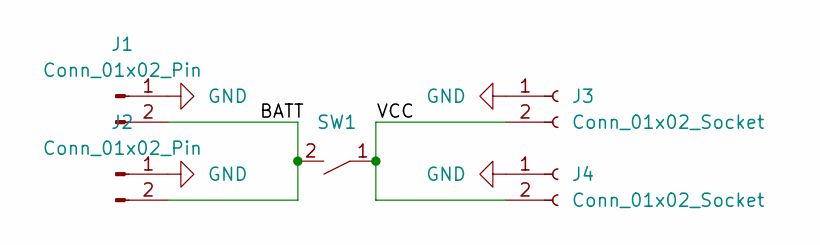
[picture p24: schematic PowerSwitch.kicad_sch]

Parts:
J1, J2: Conn_01x02_Pin; AMASS_XT30UPB-F_1x02_P5.0mm_Vertical
J3, J4: Conn_01x02_Socket; AMASS_XT30UPB-F_1x02_P5.0mm_Vertical
SW1: SMTSO2515_Switch

Connections:
/BATT: J1.2, J2.2, SW1.2
/VCC: J3.2, J4.2, SW1.1
GND: J1.1, J2.1, J3.1, J4.1

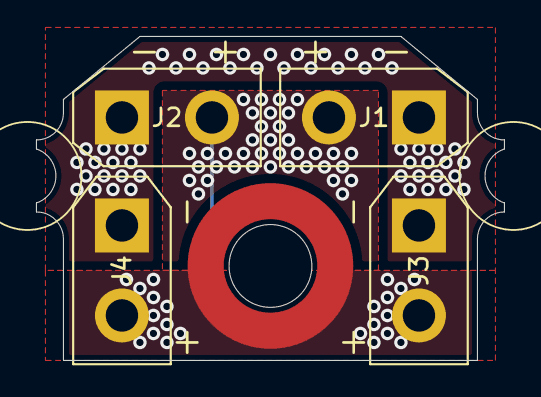
[picture p25: board PowerSwitch.kicad_pcb from above]

Board: 4 copper layers, 26.0 x 18.0 mm, 5 parts (0 on the bottom side), 3 nets.
