gavin4d/dangerDoughnut/firmware/components/MMC5983MA/MMC5983MA.cpp

#include "MMC5983MA.h"
#include "MathUtils.h"
#include "driver/spi_master.h"
#include "esp_intr_alloc.h"
#include "esp_log.h"
#include <bits/std_thread.h>
#include <cstddef>
#include <cstdint>
#include <cstdio>
#include <cstring>
#include "esp_timer.h"
#include "freertos/task.h"

#include "driver/gpio.h"
#include "hal/gpio_types.h"
#include "soc/gpio_num.h"

MMC5983MA::MMC5983MA() {
}

MMC5983MA::~MMC5983MA() {
    free(rx_buffer);
    free(tx_buffer);
}

/*************************************************************************/
/*!
    @brief  Writes 8-bits to the specified destination register

    @param reg The register to write to
    @param value The value to write to the register
*/
/**************************************************************************/

void MMC5983MA::writeRegister(uint8_t reg, uint8_t value) {
    spi_transaction_t transaction = {0};
    transaction.flags = SPI_TRANS_USE_TXDATA;
    transaction.addr = reg | MMC_WRITE;
    transaction.tx_data[0] = value;
    transaction.length = 8;
    // ESP_LOGI("addr_w", "%02x", (uint8_t)transaction.tx_data[0]);

    ret=spi_device_transmit(device, &transaction);
    assert(ret==ESP_OK);
}

/**************************************************************************/
/*!
    @brief  Reads 8-bits from the specified register

    @param reg register to read

    @return The results of the register read request
*/
/**************************************************************************/
uint8_t MMC5983MA::readRegister(uint8_t reg) {
    spi_transaction_t transaction = {0};
    transaction.flags = SPI_TRANS_USE_RXDATA;
    transaction.addr = reg | MMC_READ;
    transaction.length = 8;
    transaction.rxlength = 8;
    // ESP_LOGI("addr_r", "%2x", (uint8_t)transaction.tx_data[0]);

    ret=spi_device_transmit(device, &transaction);
    assert(ret==ESP_OK);
    // ESP_LOGI("read", "%2x", transaction.rx_data[1]);

    return transaction.rx_data[0];
}

/**************************************************************************/
/*!
    @brief  Read the device ID (can be used to check connection)

    @return The 8-bit device ID
*/
/**************************************************************************/
uint8_t MMC5983MA::getDeviceID(void) {
  // Check device ID register
  return readRegister(MMC_PRODUCT_ID_1);
}

/**************************************************************************/
/*!
    @brief  Gets the most recent X axis value

    @return The 16-bit signed value for the X axis
*/
/**************************************************************************/
int16_t MMC5983MA::readX(void) { return 0; }

/**************************************************************************/
/*!
    @brief  Gets the most recent Y axis value

    @return The 16-bit signed value for the Y axis
*/
/**************************************************************************/
int16_t MMC5983MA::readY(void) { return 0; }

/**************************************************************************/
/*!
    @brief  Gets the most recent Z axis value

    @return The 16-bit signed value for the Z axis
*/
/**************************************************************************/
int16_t MMC5983MA::readZ(void) { return 0; }

/**************************************************************************/
/*!
    @brief  Reads 3x16-bits from the x, y, and z data register
    @param vec reference to return vector of magnetic field data
    @return True if the operation was successful, otherwise false.
*/
/**************************************************************************/
bool MMC5983MA::readXYZ(vec3<int16_t> &vec) {
    // ESP_LOGI("mag", "status: %02x", readRegister(MMC_STATUS));
    spi_transaction_t transaction;
    transaction.flags = 0;
    transaction.addr = MMC_X_OUT_0 | MMC_READ;
    transaction.length = 8*6;
    transaction.rxlength = 0; // same as length
    transaction.tx_buffer = NULL;
    transaction.rx_buffer = rx_buffer;

    ret=spi_device_acquire_bus(device, portMAX_DELAY);
    assert(ret==ESP_OK);
    ret=spi_device_polling_transmit(device, &transaction);
    assert(ret==ESP_OK);
    spi_device_release_bus(device);

    // vec.x = (rx_buffer[1] << 10 | rx_buffer[2] << 2 | ((rx_buffer[7] >> 6) & 0b11)) - (1 << 17) + offset.x;
    // vec.y = (rx_buffer[3] << 10 | rx_buffer[4] << 2 | ((rx_buffer[7] >> 4) & 0b11)) - (1 << 17) + offset.y;
    // vec.z = (rx_buffer[5] << 10 | rx_buffer[6] << 2 | ((rx_buffer[7] >> 2) & 0b11)) - (1 << 17) + offset.z;
    vec.x = (rx_buffer[0] << 8 | rx_buffer[1]) - (1<<15) - offset.x;
    vec.y = (rx_buffer[2] << 8 | rx_buffer[3]) - (1<<15) - offset.y;
    vec.z = (rx_buffer[4] << 8 | rx_buffer[5]) - (1<<15) - offset.z;

    // if(receive_flag || gpio_get_level(GPIO_NUM_34)) {
    //     // ESP_LOGI("mag", "status: %02x", readRegister(MMC_STATUS));
    //     printf(" %llu %u\n", (MMC5983MA::receive_time), (uint8_t)gpio_get_level(GPIO_NUM_34));
    //     writeRegister(MMC_STATUS, 0b1);
    //     // writeRegister(MMC_INTERNAL_CONTROL_0, MMC_TAKE_MEASURMENT_M | MMC_INT_EN);
    //     // MMC5983MA::send_time = esp_timer_get_time();
    //     receive_flag = 0;
    //     // vTaskDelay(8);
    //     // ESP_LOGI("mag", "status: %02x", readRegister(MMC_STATUS));
    // }
    return true;
}

/**************************************************************************/
/*!
    @brief  Reads 3x16-bits from the x, y, and z data register
    @param x reference to return x magnetic field data
    @param y reference to return y magnetic field data
    @param z reference to return z magnetic field data
    @return True if the operation was successful, otherwise false.
*/
/**************************************************************************/
bool MMC5983MA::readXY(vec2<int16_t> &vec) {
    spi_transaction_t transaction;
    transaction.flags = 0;
    transaction.addr = MMC_X_OUT_0 | MMC_READ;
    transaction.length = 8*4;
    transaction.rxlength = 0; // same as length
    transaction.tx_buffer = NULL;
    transaction.rx_buffer = rx_buffer;

    ret=spi_device_acquire_bus(device, portMAX_DELAY);
    assert(ret==ESP_OK);
    ret=spi_device_polling_transmit(device, &transaction);
    assert(ret==ESP_OK);
    spi_device_release_bus(device);

    // vec.x = (rx_buffer[1] << 10 | rx_buffer[2] << 2 | ((rx_buffer[7] >> 6) & 0b11)) - (1 << 17) + offset.x;
    // vec.y = (rx_buffer[3] << 10 | rx_buffer[4] << 2 | ((rx_buffer[7] >> 4) & 0b11)) - (1 << 17) + offset.y;
    vec.x = (rx_buffer[0] << 8 | rx_buffer[1]) - (1<<15) - offset.x;
    vec.y = (rx_buffer[2] << 8 | rx_buffer[3]) - (1<<15) - offset.y;
    return true;
}

// uint64_t MMC5983MA::receive_time = 0;
// uint8_t MMC5983MA::receive_flag = 0;
// uint64_t MMC5983MA::send_time = 0;
// static void IRAM_ATTR gpio_interrupt_handler(void *args)
// {
//     MMC5983MA::receive_time = esp_timer_get_time() - MMC5983MA::send_time;
//     MMC5983MA::send_time = esp_timer_get_time();
//     MMC5983MA::receive_flag = 1;
// }

/**************************************************************************/
/*!
    @brief  Setups the HW (reads coefficients values, etc.)
    @return True if the sensor was successfully initialised.
*/
/**************************************************************************/
bool MMC5983MA::setup(sensor_config_t config) {

    rx_buffer = (uint8_t*)heap_caps_aligned_alloc(32, 8, MALLOC_CAP_DMA);
    tx_buffer = (uint8_t*)heap_caps_aligned_alloc(32, 8, MALLOC_CAP_DMA);

    DMA_channel = config.DMA_channel;
    SPI_host = config.SPI_host;
    clock_speed = config.clock_speed;
    bus_config = {
        .mosi_io_num = config.mosi_pin,
        .miso_io_num = config.miso_pin,
        .sclk_io_num = config.clock_pin,
        .quadwp_io_num = -1,
        .quadhd_io_num = -1,
        .max_transfer_sz = 0
    };
    
    ret=spi_bus_initialize(SPI_host, &bus_config, DMA_channel);
    assert(ret==ESP_OK || ret==ESP_ERR_INVALID_STATE); // continue if bus is already initialized

    spi_device_interface_config_t dev_config = {
        .command_bits = 0,
        .address_bits = 8,
        .mode = 3,
        .cs_ena_posttrans = 0,
        .clock_speed_hz = (int)config.clock_speed, // why is clock speed a signed int????
        .spics_io_num = config.cs_pin,
        .queue_size = 1,
        .pre_cb = NULL,
        .post_cb = NULL,
    };

    ret=spi_bus_add_device(SPI_host, &dev_config, &device);
    assert(ret==ESP_OK);

    writeRegister(MMC_INTERNAL_CONTROL_1, 0b10000000); // Reset
    vTaskDelay(100);
    
    // Check connection
    if (getDeviceID() != 0x30) {
        // No MMC5983MA detected ... return false
        return false;
    }
    // const gpio_num_t INPUT_PIN = GPIO_NUM_34;

    // gpio_config_t test_config = gpio_config_t{
    //     .pin_bit_mask = ((uint64_t)1 << 34),
    //     .mode = GPIO_MODE_INPUT,
    //     .pull_up_en = GPIO_PULLUP_DISABLE,
    //     .pull_down_en = GPIO_PULLDOWN_ENABLE,
    //     .intr_type = GPIO_INTR_POSEDGE,
    // };
    // gpio_config(&test_config);
    // gpio_install_isr_service(0);
    // gpio_isr_handler_add(INPUT_PIN, gpio_interrupt_handler, nullptr);

    // gpio_dump_io_configuration(stdout, SOC_GPIO_VALID_GPIO_MASK);

    // Data rate
    vTaskDelay(1);
    writeRegister(MMC_INTERNAL_CONTROL_1, MMC_BANDWIDTH_800_HZ);

    vec3<int16_t> vec_1 = {0,0,0};
    vec3<int16_t> vec_2 = {0,0,0};
    // SET and RESET to find sensor offsets
    vTaskDelay(10);
    writeRegister(MMC_INTERNAL_CONTROL_0, MMC_TAKE_MEASURMENT_M);
    vTaskDelay(10);

    writeRegister(MMC_INTERNAL_CONTROL_0, MMC_RESET);
    vTaskDelay(10);
    writeRegister(MMC_INTERNAL_CONTROL_0, MMC_SET);
    vTaskDelay(10);

    writeRegister(MMC_INTERNAL_CONTROL_0, MMC_AUTO_SR | MMC_INT_EN); // Auto set/reset
    vTaskDelay(10);
    writeRegister(MMC_STATUS, 0b1);

    // writeRegister(MMC_INTERNAL_CONTROL_2, MMC_DATARATE_1000_HZ);
    // vTaskDelay(1);
    // writeRegister(MMC_INTERNAL_CONTROL_2, MMC_DATARATE_1000_HZ | MMC_EN_PRD_SET | MMC_SET_100);
    vTaskDelay(10);
    writeRegister(MMC_INTERNAL_CONTROL_1, MMC_BANDWIDTH_800_HZ);
    vTaskDelay(10);
    writeRegister(MMC_INTERNAL_CONTROL_2, 0b10101111);
    // writeRegister(MMC_INTERNAL_CONTROL_2, MMC_CONTINUOUS_MODE | MMC_DATARATE_1000_HZ | MMC_EN_PRD_SET | MMC_SET_100);
    // vTaskDelay(1);
    // writeRegister(MMC_INTERNAL_CONTROL_0, MMC_AUTO_SR | MMC_INT_EN);
    // vTaskDelay(8);
    // send_time = esp_timer_get_time();

    // ESP_LOGI("mag", "status: %02x", readRegister(MMC_STATUS));
    // for (int i = 0; i <= 0xC; i++) {
    //     ESP_LOGI("mag", "%d: %02x", i, readRegister(i));
    // }
    // receive_flag = 1;

    return true;
}
