gavin4d/dangerDoughnut/firmware/components/DonutDisplay/imageConverter.py

import sys
from PIL import Image, ImagePalette
from numpy import asarray

palette32 = [
    0x00, 0x00, 0x00,
    0xfc, 0xfc, 0xfc,
    0xc4, 0xc7, 0xee,
    0x9a, 0x8f, 0xe0,
    0x63, 0x5d, 0x96,
    0x29, 0x2f, 0x65,
    0x1b, 0x1d, 0x34,
    0xff, 0xe3, 0xae,
    0xcd, 0xbb, 0xab,
    0xa6, 0x85, 0x8f,
    0xcf, 0x5d, 0x8b,
    0x96, 0x49, 0x68,
    0xff, 0xb4, 0x82,
    0xdd, 0x86, 0x7d,
    0xb2, 0x69, 0x6f,
    0xf6, 0xc6, 0x5e,
    0xe4, 0x90, 0x57,
    0xc4, 0x68, 0x33,
    0xb0, 0xd0, 0x7e,
    0x66, 0xaa, 0x5d,
    0x52, 0xb5, 0xab,
    0x2a, 0x83, 0x79,
    0x1c, 0x56, 0x59,
    0x7b, 0xe1, 0xf6,
    0x58, 0x9f, 0xfc,
    0x50, 0x69, 0xe4,
    0x2e, 0x44, 0xae,
    0x80, 0x56, 0xd4,
    0x5a, 0x3b, 0x96,
    0xff, 0xba, 0xe1,
    0xe6, 0x87, 0xc5,
    0xa7, 0x59, 0xb9
]
p_img = Image.new('P', (32, 8))
p_img.putpalette(palette32 * 8)
for arg in sys.argv[1:]:
    image = Image.open(arg)
    image = image.quantize(palette=p_img, dither=0)
    # print(arg.split(".")[-2] + "_palette." + arg.split('.')[-1])
    image.save("_" + arg.split("/")[-1])
    # image.show()
    data = asarray(image)
    output = "const unsigned int sprite [] = {\n"
    for row in data:
        for pixel in row:
            output += "{:01x}, ".format(pixel)
    output = output[:-2]
    output += "\n};"
    print(output)
