gavin4d/dangerDoughnut/(commit log)

2024-08-08 angled xt30
    [PowerSwitch.kicad_pcb, PowerSwitch.kicad_sch]
2024-08-08 right angle xt30
    [XT30RightAngleAdapter.kicad_pcb, XT30RightAngleAdapter.kicad_sch, XT30RightAngleAdapter.step, XT30RightAngleAdapterF.step, XT30RightAngleAdapter_panelized.kicad_pcb, bom.csv, designators.csv, positions.csv]
2024-09-10 verified elsr
    [DangerDoughnut.kicad_pcb, DangerDoughnut.kicad_sch]
2024-09-13 updated schematic
    [DangerDoughnut.kicad_sch]
2024-09-21 updated schematic power layout done
    [DangerDoughnut.kicad_pcb, DangerDoughnut.kicad_sch]
2024-09-22 updated layout
    [DangerDoughnut.kicad_pcb, DangerDoughnut.kicad_sch]
2024-09-24 updated layout needs 3v3 headers testpoints and verify
    [DangerDoughnut.kicad_pcb, DangerDoughnut.kicad_sch]
2024-09-24 Added silkscreen
    [DangerDoughnut.kicad_pcb]
2024-09-26 main layout complete needs headers and testpoints
    [DangerDoughnut.kicad_pcb, LEDStick.kicad_pcb, LEDStick.kicad_sch, bom.csv, positions.csv]
2024-09-29 esp32 pins checked
    [DangerDoughnut.kicad_pcb, DangerDoughnut.kicad_sch]
2024-10-19 test points done
    [DangerDoughnut.kicad_pcb, DangerDoughnut.kicad_sch]
2024-10-20 Layout Done
    [DangerDoughnut.kicad_pcb, DangerDoughnut.kicad_sch]
2024-10-24 boards ordered
    [DangerDoughnut.kicad_pcb, DangerDoughnut.kicad_sch, LEDStick.kicad_pcb]
2025-03-31 added a few things
    [DangerDoughnut-B_Cu.gbr, DangerDoughnut-B_Mask.gbr, DangerDoughnut-B_Paste.gbr, DangerDoughnut-B_Silkscreen.gbr, DangerDoughnut-Edge_Cuts.gbr, DangerDoughnut-F_Cu.gbr, DangerDoughnut-F_Mask.gbr, DangerDoughnut-F_Paste.gbr]
2025-06-06 Sensors and feedforwards physics
